mirroschool-ua/SunnyLab/Інструкція користувача SunnyLab з паянням.pdf

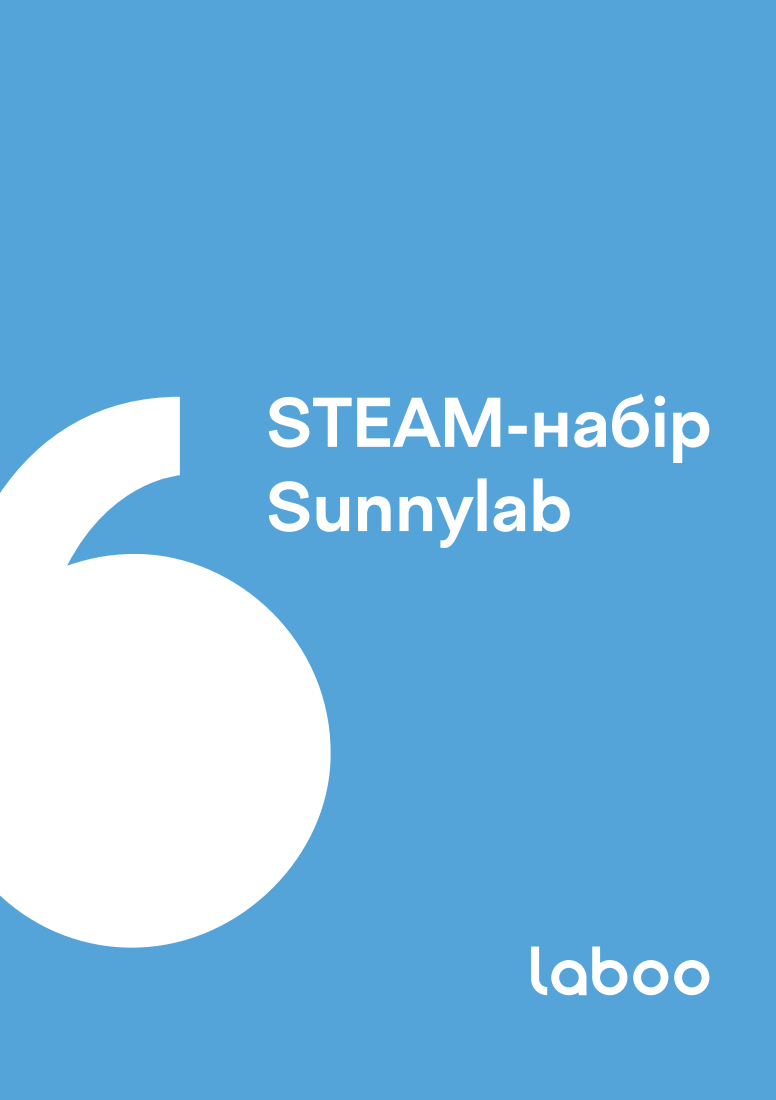
[picture p1: page 1]

2

3

# Зміст

### 1. Перелік компонентів та інструментів

### 2. Монтаж компонентів на друковану плату

2.1. Підключення паяльника
2.2. Монтаж компонентів

### 3. Налаштування середовища Arduino IDE

та завантаження прошивки метеостанції
3.1. Завантаження та встановлення середовища програмування Arduino IDE
3.2. Налаштування середовища для роботи
з платою мікроконтролера
3.3. Завантаження прошивки

### 4. Налаштування дисплею

та збирання в корпус

4

5

14

20

# 1. Перелік компонентів та інструментів

2

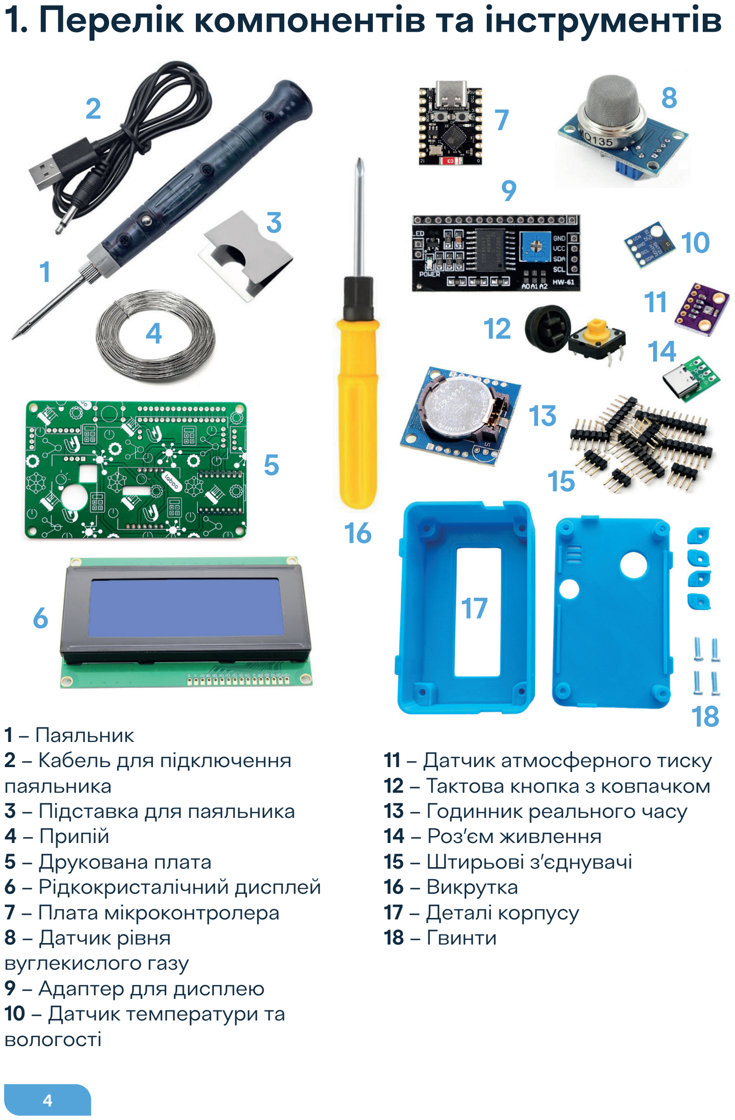
[picture p2: page 4]

4

1 – Паяльник
2 – Кабель для підключення паяльника
3 – Підставка для паяльника 4 – Припій
5 – Друкована плата
6 – Рідкокристалічний дисплей 7 – Плата мікроконтролера
8 – Датчик рівня
вуглекислого газу
9 – Адаптер для дисплею
10 – Датчик температури та вологості

11 – Датчик атмосферного тиску 12 – Тактова кнопка з ковпачком 13 – Годинник реального часу 14 – Роз’єм живлення
15 – Штирьові з’єднувачі
16 – Викрутка
17 – Деталі корпусу
18 – Гвинти

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
4 12

8

11
14

17

18

16

# 2. Монтаж компонентів на друковану плату

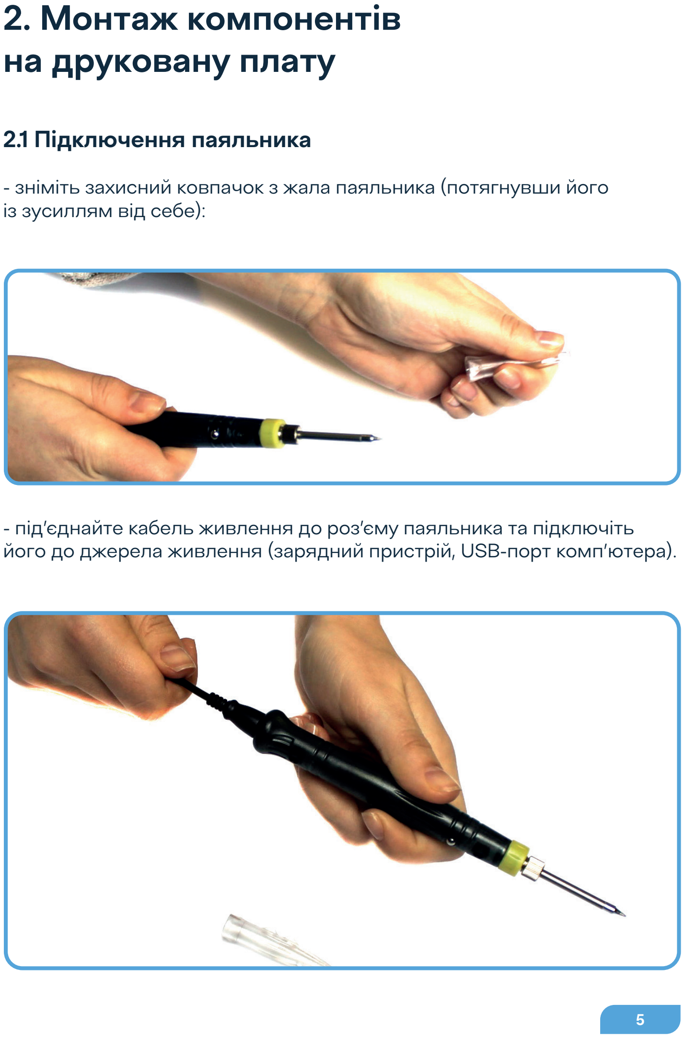
[picture p3: page 5]

5

- зніміть захисний ковпачок з жала паяльника (потягнувши його із зусиллям від себе):

### 2.1 Підключення паяльника

- під’єднайте кабель живлення до роз’єму паяльника та підключіть його до джерела живлення (зарядний пристрій, USB-порт комп’ютера).

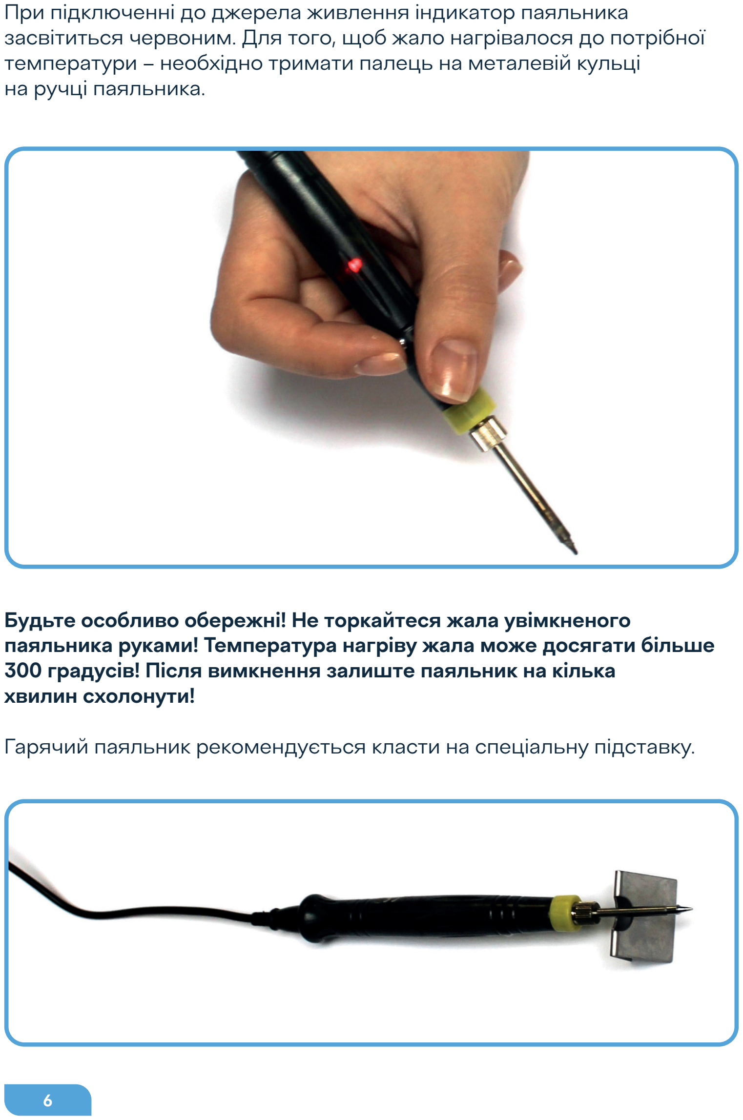
[picture p4: page 6]

6

При підключенні до джерела живлення індикатор паяльника засвітиться червоним. Для того, щоб жало нагрівалося до потрібної температури – необхідно тримати палець на металевій кульці
на ручці паяльника.

Будьте особливо обережні! Не торкайтеся жала увімкненого паяльника руками! Температура нагріву жала може досягати більше 300 градусів! Після вимкнення залиште паяльник на кілька
хвилин схолонути!

Гарячий паяльник рекомендується класти на спеціальну підставку.

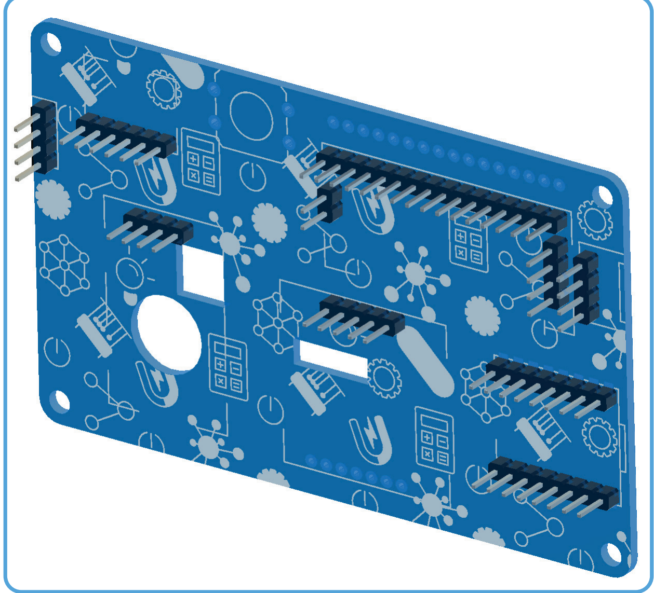
[picture p5: figure]

7

### 2.2 Монтаж компонентів

- візьміть друковану плату метеостанції, вставте в отвори штирьові з’єднувачі в місцях, показаних на зображенні.
- переверніть плату на іншу сторону та запаяйте контакти (рекомендується спочатку нагріти жалом паяльника контакт з’єднувача, а тоді підносити до нього припій). Рекомендується спочатку запаяти один контакт, вирівняти перпендикулярно до плати всю гребінку з’єднувачів (за потреби), а тоді припаювати інші контакти. Слідкуйте за тим, щоб припаяні контакти не були з’єднані між собою!

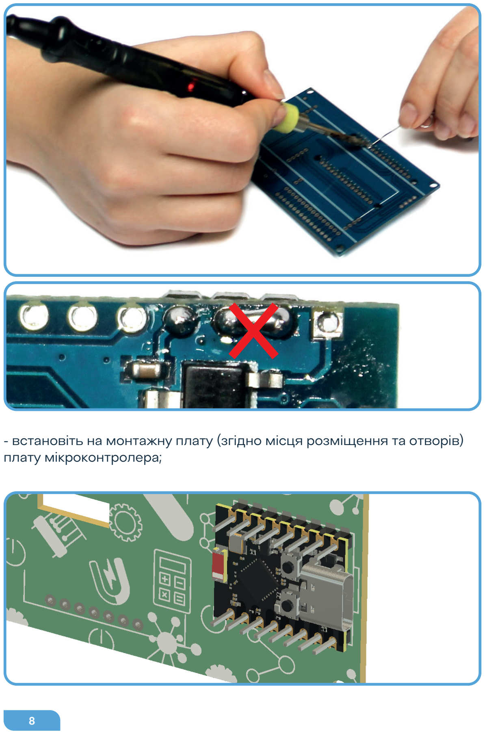
[picture p6: page 8]

8

- встановіть на монтажну плату (згідно місця розміщення та отворів) плату мікроконтролера;

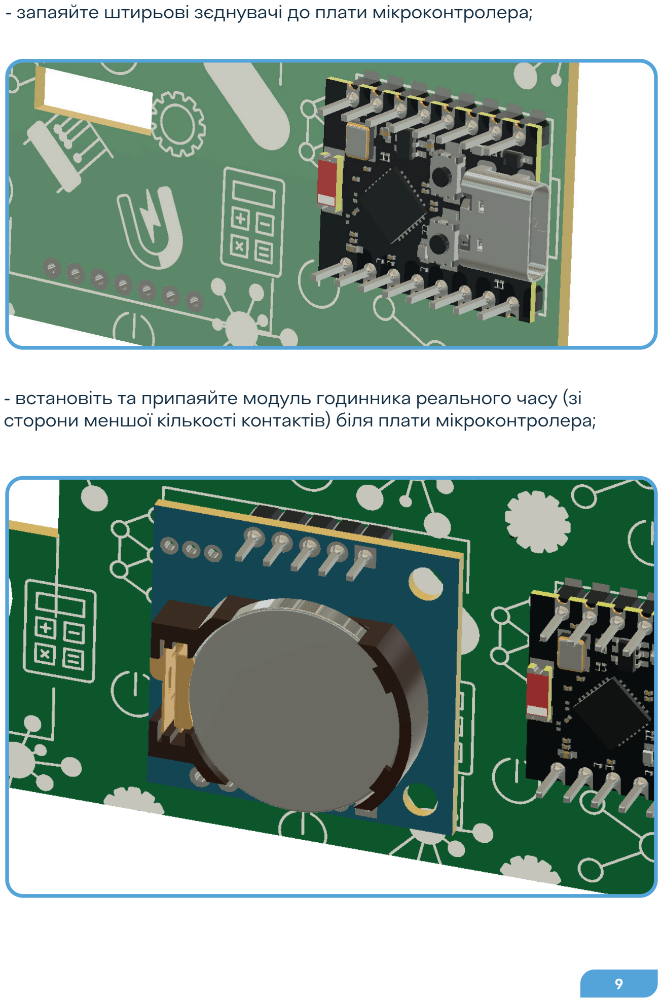
[picture p7: page 9]

9

- запаяйте штирьові зєднувачі до плати мікроконтролера;
- встановіть та припаяйте модуль годинника реального часу (зі сторони меншої кількості контактів) біля плати мікроконтролера;

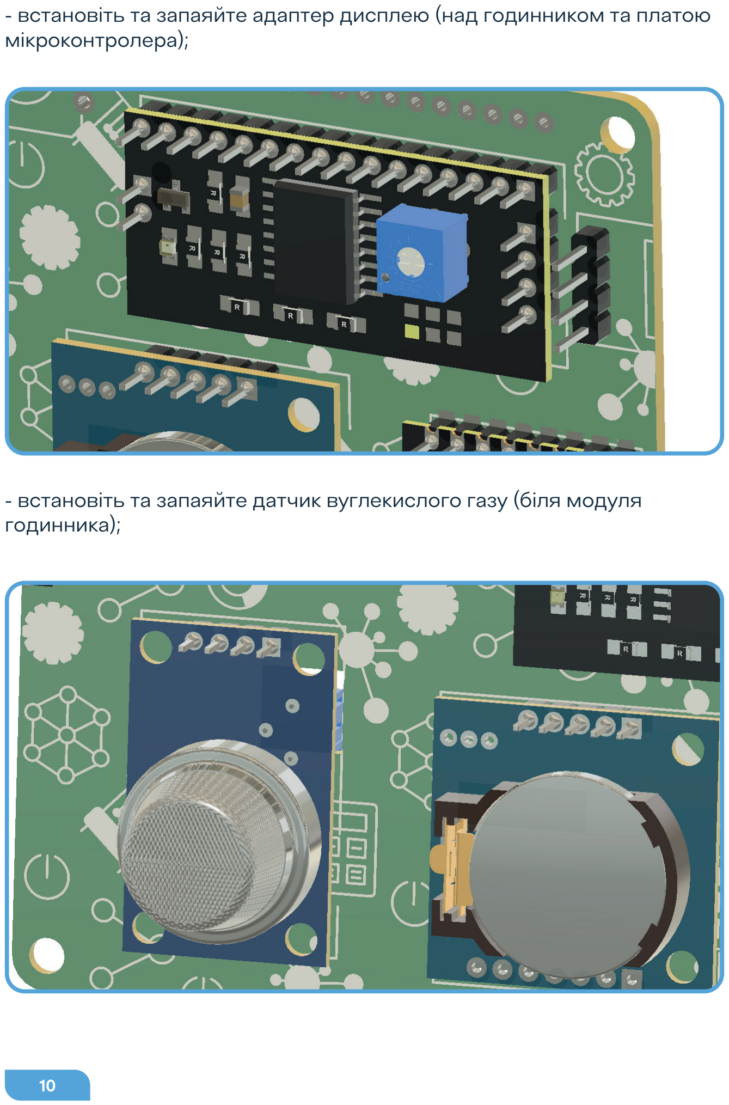
[picture p8: page 10]

10

- встановіть та запаяйте адаптер дисплею (над годинником та платою мікроконтролера);
- встановіть та запаяйте датчик вуглекислого газу (біля модуля годинника);

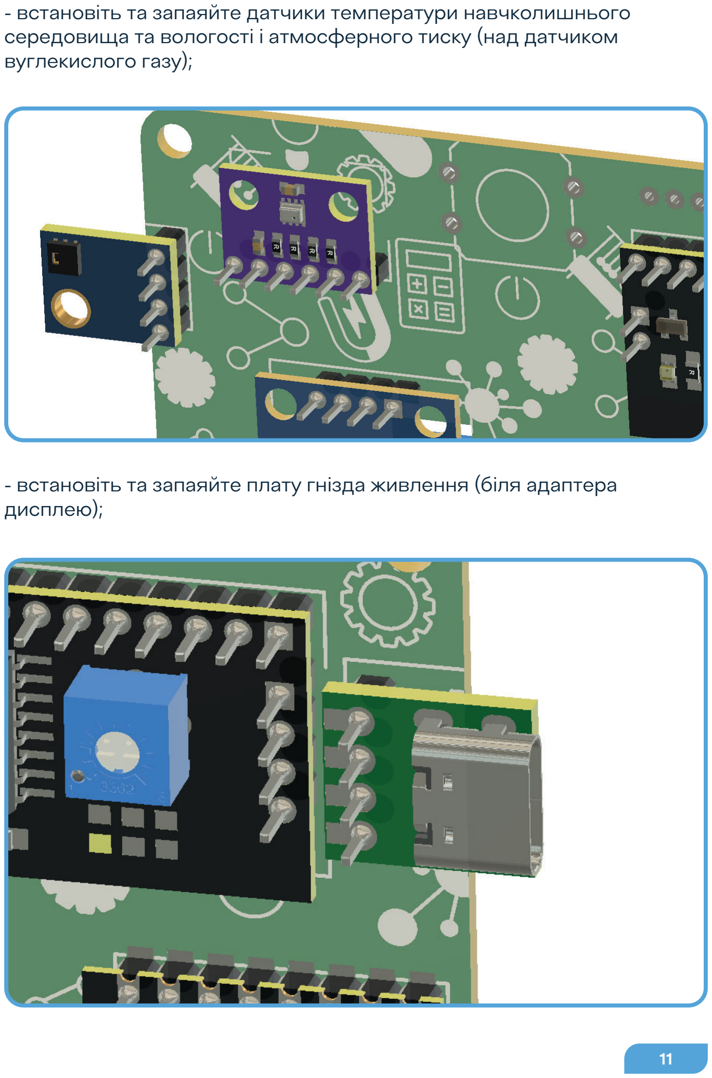
[picture p9: page 11]

11

- встановіть та запаяйте датчики температури навчколишнього середовища та вологості і атмосферного тиску (над датчиком вуглекислого газу);
- встановіть та запаяйте плату гнізда живлення (біля адаптера дисплею);

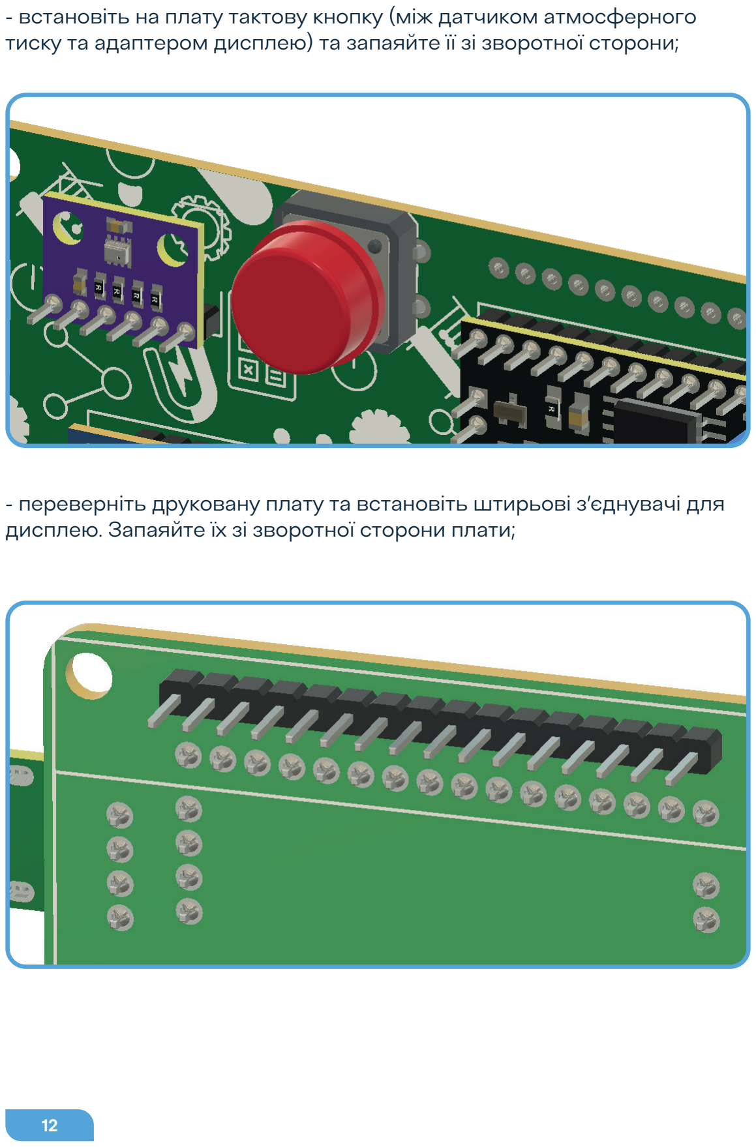
[picture p10: page 12]

12

- встановіть на плату тактову кнопку (між датчиком атмосферного тиску та адаптером дисплею) та запаяйте її зі зворотної сторони;
- переверніть друковану плату та встановіть штирьові з’єднувачі для дисплею. Запаяйте їх зі зворотної сторони плати;

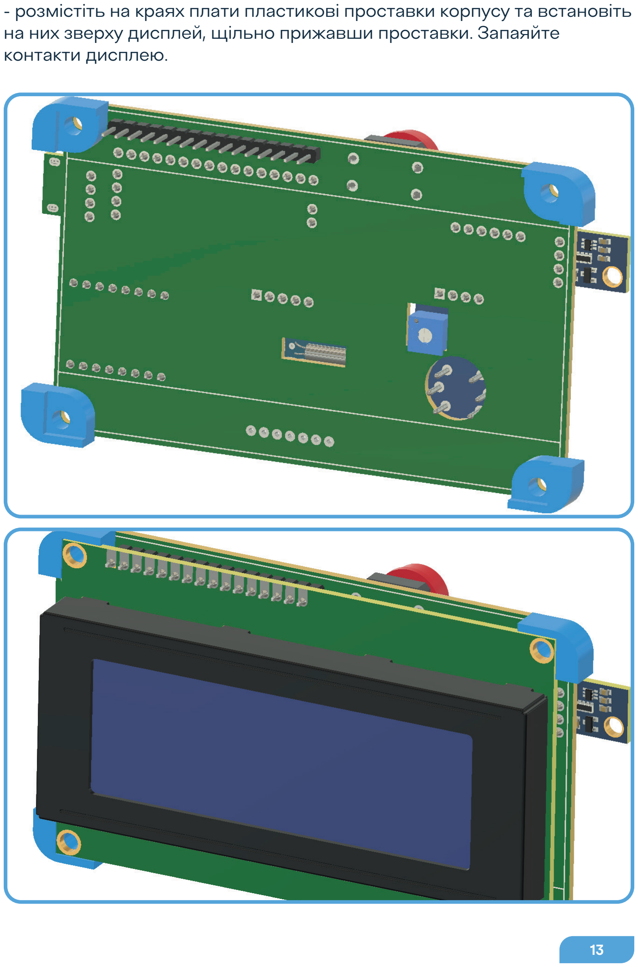
[picture p11: page 13]

13

- розмістіть на краях плати пластикові проставки корпусу та встановіть на них зверху дисплей, щільно прижавши проставки. Запаяйте контакти дисплею.

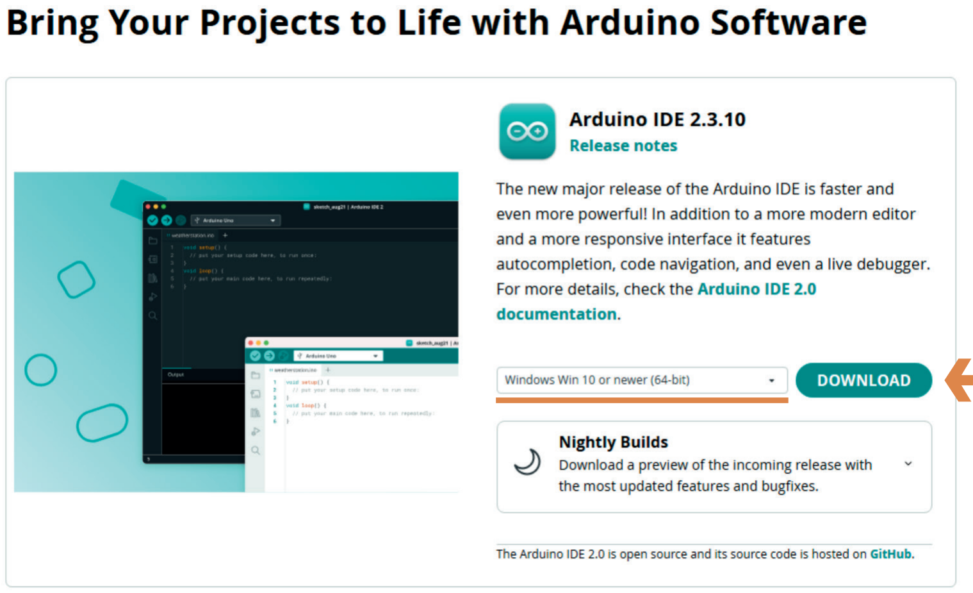
[picture p12: figure]

14

- перейдіть за посиланням (https://www.arduino.cc/en/software) на офіційний сайт Arduino та завантажте останню версію програмного забезпечення (виберіть пункт Windows Win 10 and newer) та підтвердіть завантаження натиснувши Download:

# 3. Налаштування середовища Arduino IDE та завантаження прошивки метеостанції

### 3.1. Завантаження та встановлення середовища програмування Arduino IDE

- запустіть завантажений інсталяційний файл arduino-ide_2.x.yy_ Windows_64bit.exe (де 2.x.yy – версія завантаженого програмного забезпечення), погодьтеся з ліцензійними умовами (Згоден), підтвердіть вибір користувачів, для яких встановлюється середовище (Далі >) та натисніть Встановити.

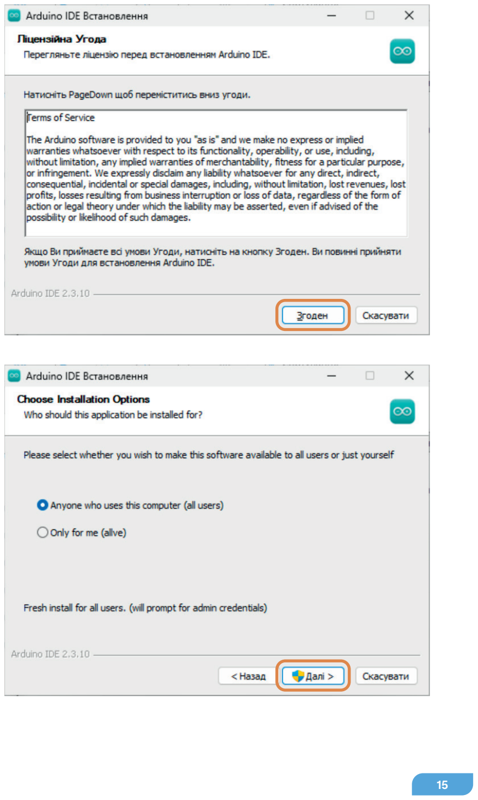
[picture p13: page 15]

15

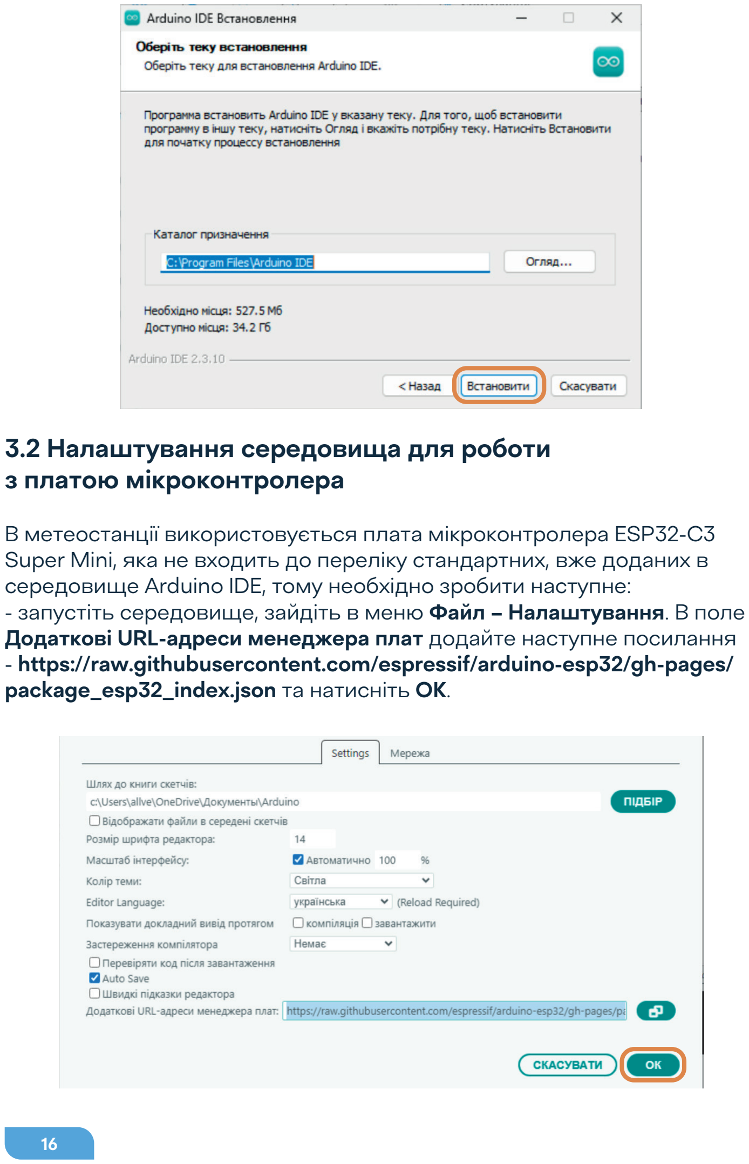
[picture p14: page 16]

16

В метеостанції використовується плата мікроконтролера ESP32-C3 Super Mini, яка не входить до переліку стандартних, вже доданих в середовище Arduino IDE, тому необхідно зробити наступне:
- запустіть середовище, зайдіть в меню Файл – Налаштування. В поле Додаткові URL-адреси менеджера плат додайте наступне посилання
- https://raw.githubusercontent.com/espressif/arduino-esp32/gh-pages/package_esp32_index.json та натисніть ОК.

### 3.2 Налаштування середовища для роботи з платою мікроконтролера

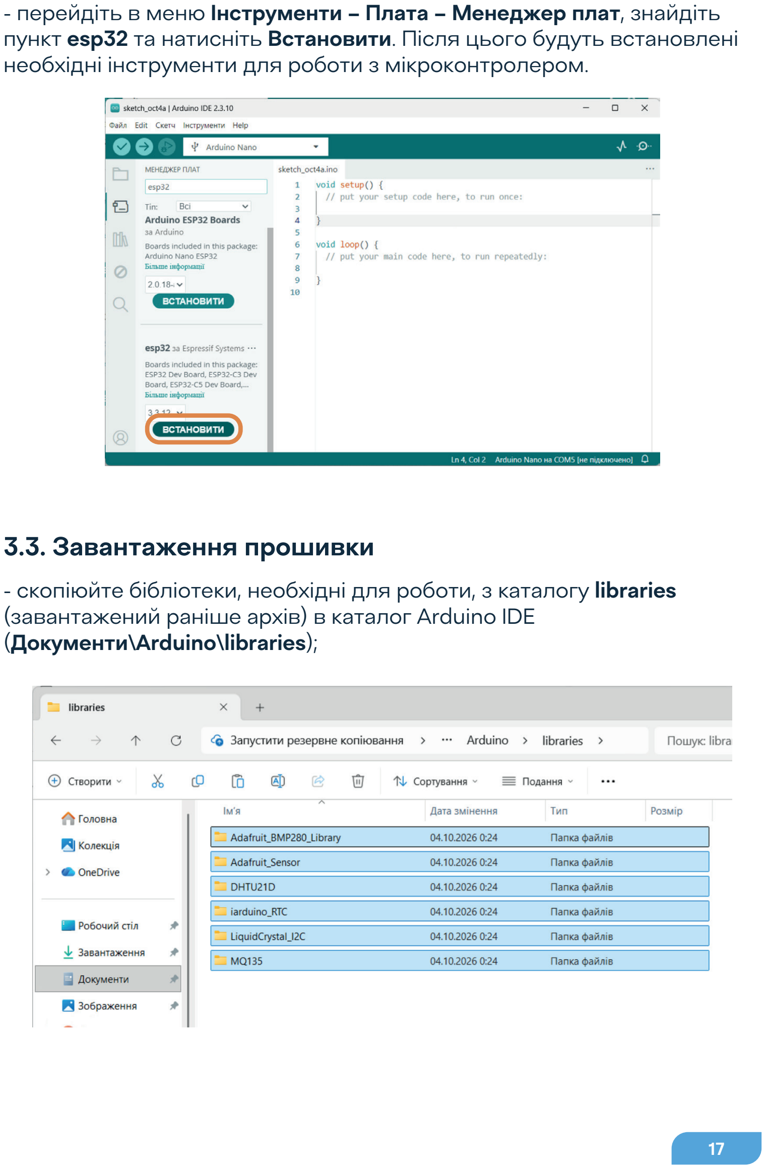
[picture p15: page 17]

17

- перейдіть в меню Інструменти – Плата – Менеджер плат, знайдіть пункт esp32 та натисніть Встановити. Після цього будуть встановлені необхідні інструменти для роботи з мікроконтролером.
- скопіюйте бібліотеки, необхідні для роботи, з каталогу libraries (завантажений раніше архів) в каталог Arduino IDE (Документи\Arduino\libraries);

### 3.3. Завантаження прошивки

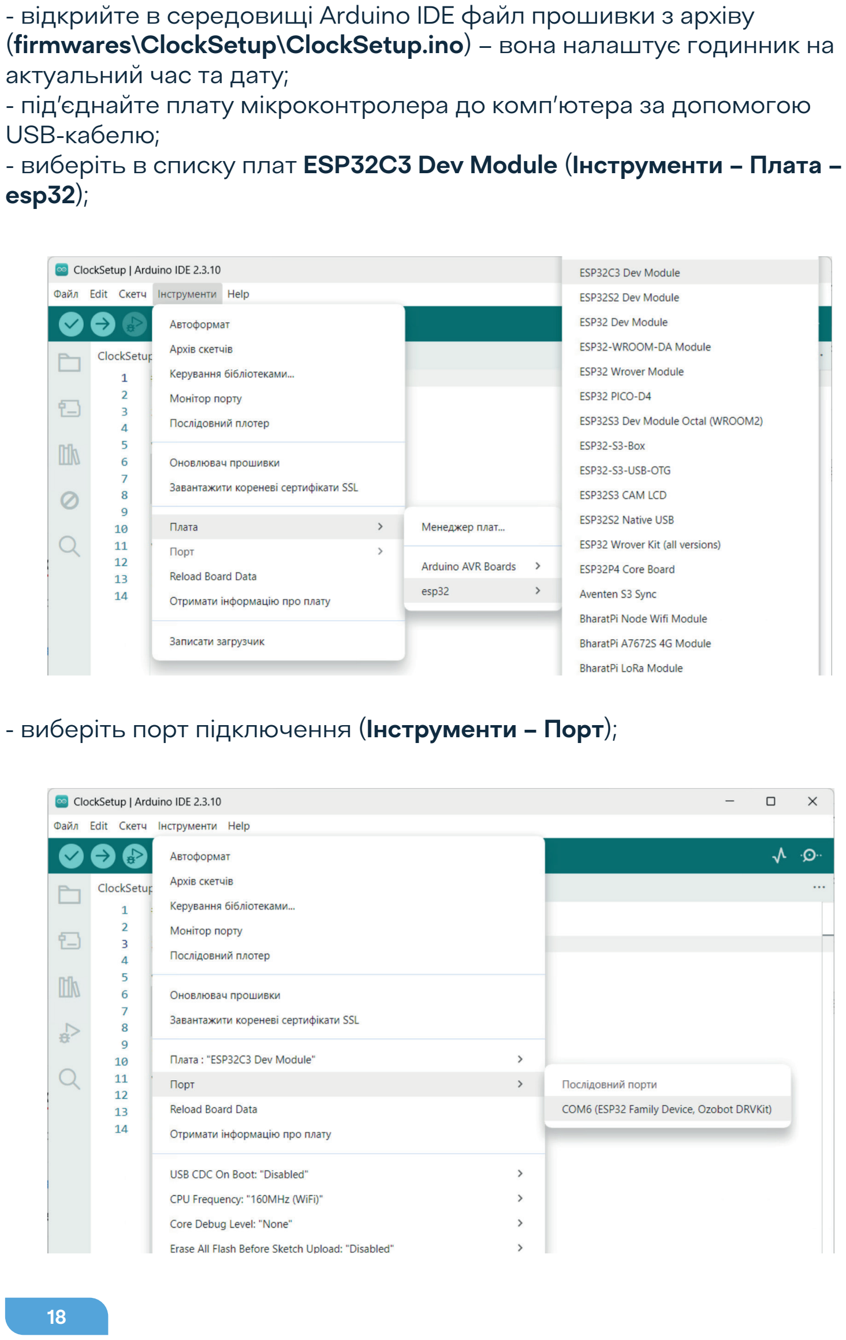
[picture p16: page 18]

18

- відкрийте в середовищі Arduino IDE файл прошивки з архіву (firmwares\ClockSetup\ClockSetup.ino) – вона налаштує годинник на актуальний час та дату;
- під’єднайте плату мікроконтролера до комп’ютера за допомогою USB-кабелю;
- виберіть в списку плат ESP32C3 Dev Module (Інструменти – Плата – esp32);
- виберіть порт підключення (Інструменти – Порт);

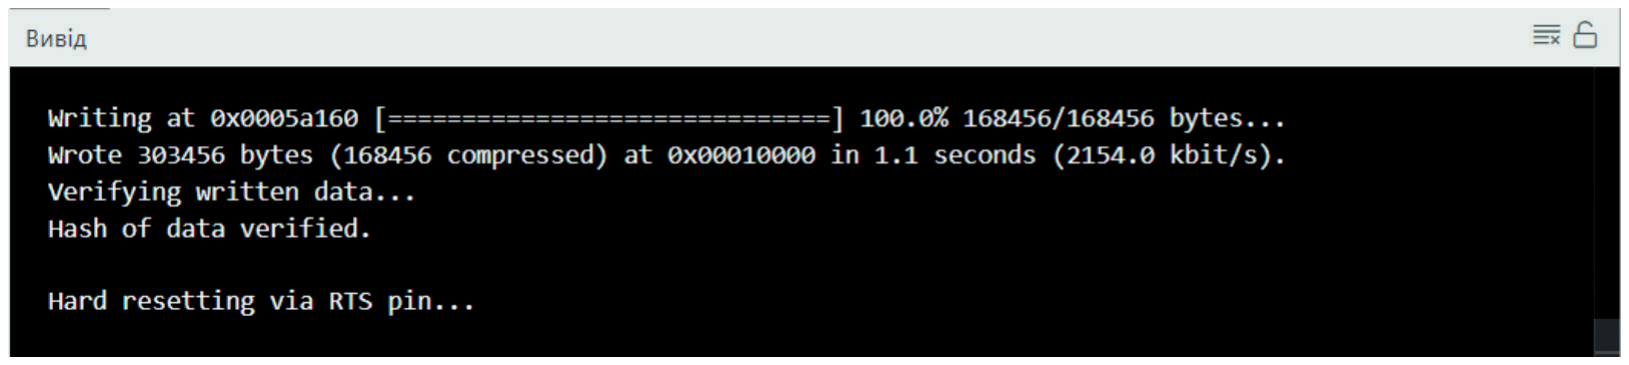
[picture p17: figure]

19

- натисніть кнопку Завантажити ( ), після чого відбудеться завантаження прошивки;
- відкрийте файл основної прошивки метеостанції з архіву (firmwares\SunnyLabSoldering\SunnyLabSoldering.ino);
- натисність Завантажити та дочекайтесь завершення.

# 4. Налаштування дисплею та збирання в корпус

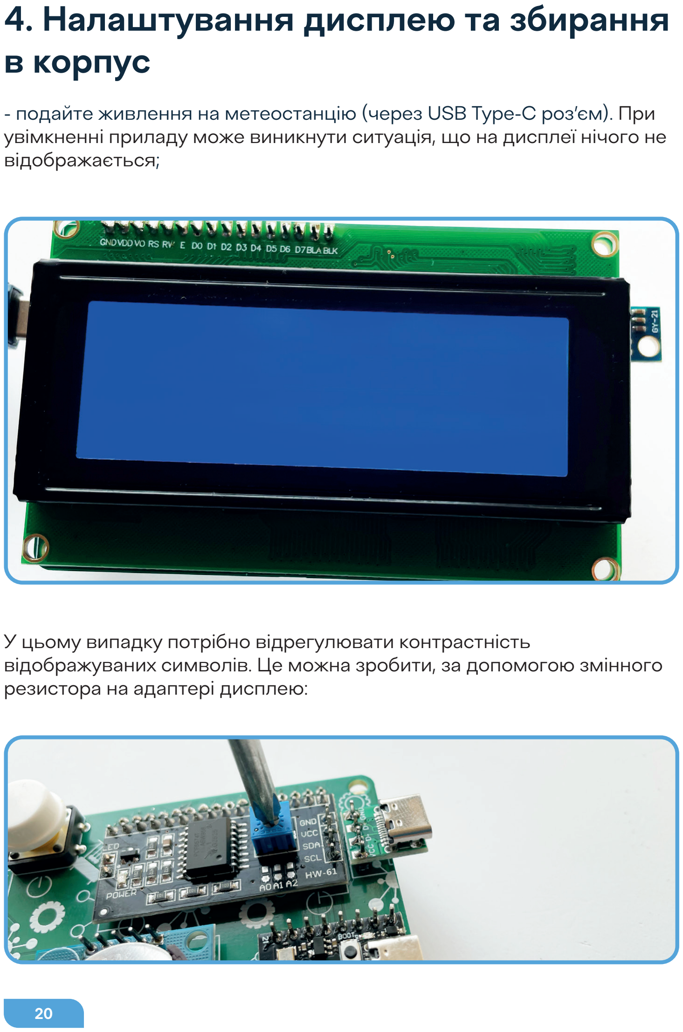
[picture p18: page 20]

20

- подайте живлення на метеостанцію (через USB Type-C роз’єм). При увімкненні приладу може виникнути ситуація, що на дисплеї нічого не відображається;

У цьому випадку потрібно відрегулювати контрастність відображуваних символів. Це можна зробити, за допомогою змінного резистора на адаптері дисплею:

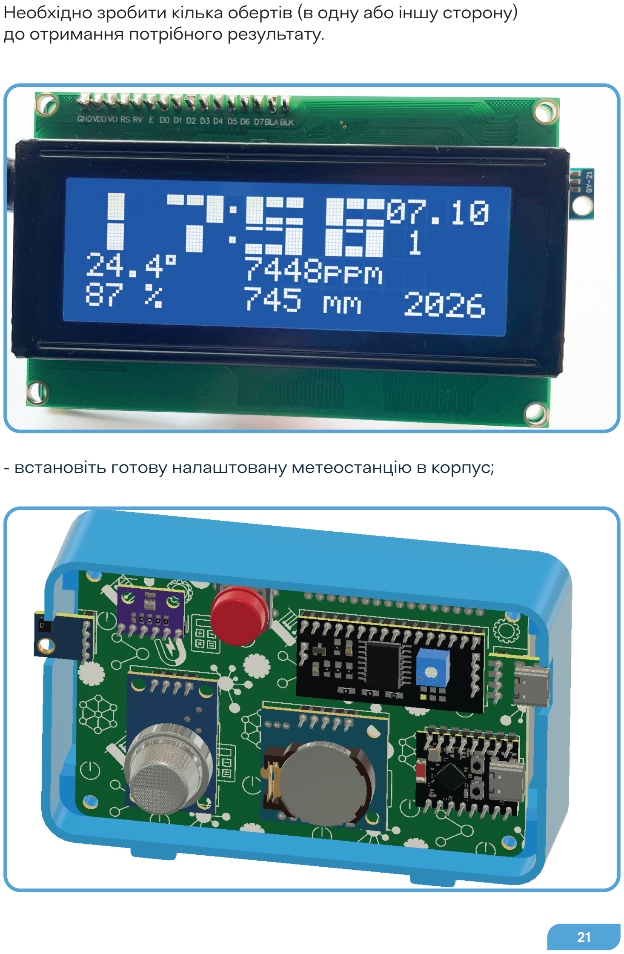
[picture p19: page 21]

21

Необхідно зробити кілька обертів (в одну або іншу сторону) до отримання потрібного результату.

- встановіть готову налаштовану метеостанцію в корпус;

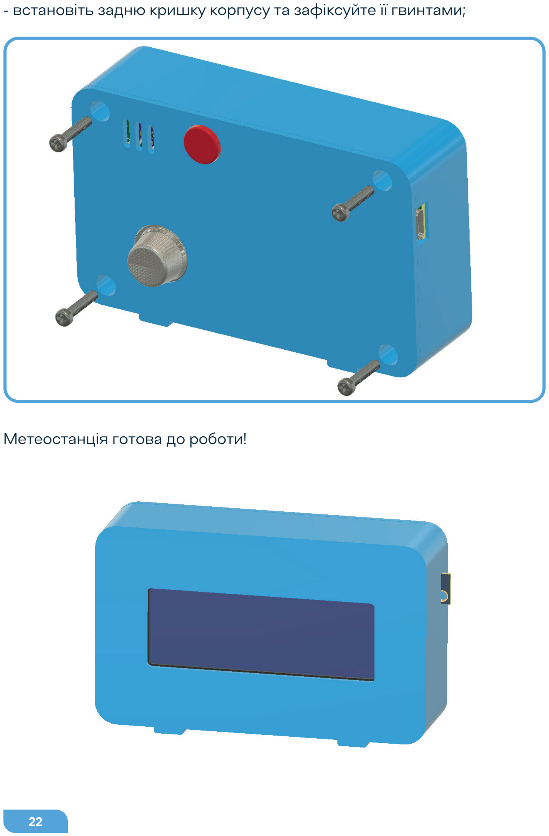
[picture p20: page 22]

22

- встановіть задню кришку корпусу та зафіксуйте її гвинтами;

Метеостанція готова до роботи!

23

info@mirroschool.com
mirroschool.com
