mirroschool-ua/SunnyLab/(commit log)

2024-01-19 unpack driver
2024-01-19 add library LiquidCrystal I2C
2026-08-26 Rename SunnyLabBreadboard.pdf to Інструкція користувача SunnyLab.pdf
